maximilian-s-puglielli/6502-Computer/Images/Front#1.jpg

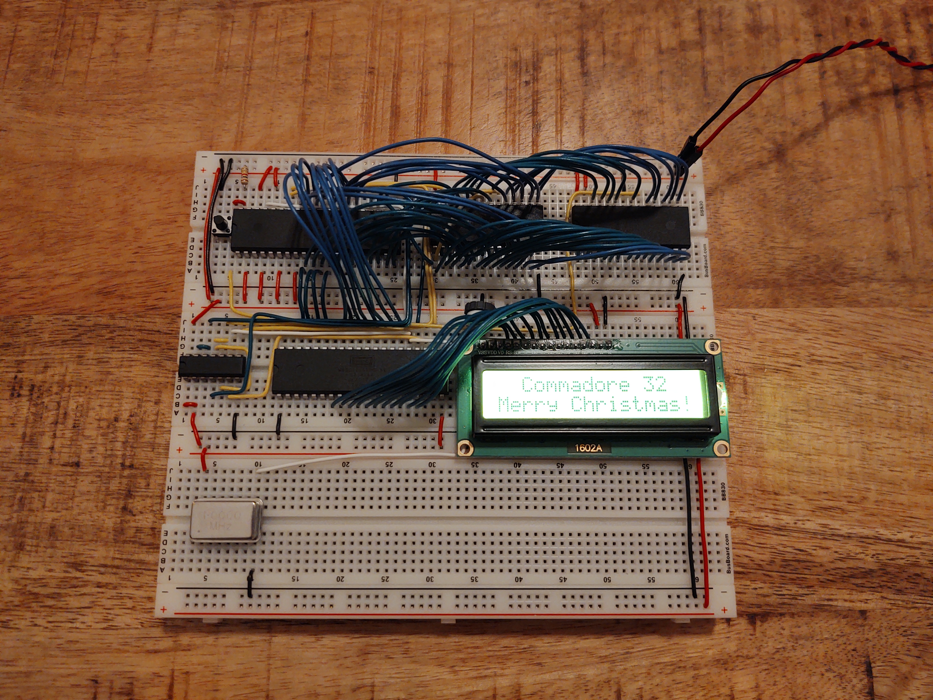
Images/Front#1.jpg
