maximilian-s-puglielli/6502-Computer/Images/FrontClose.jpg

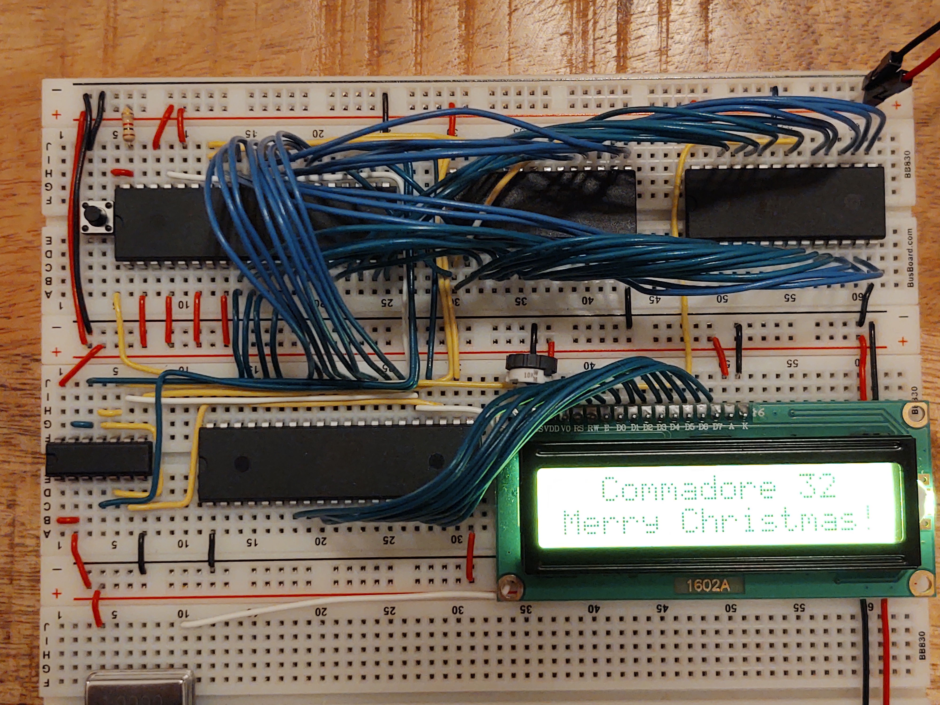
Images/FrontClose.jpg
