maximilian-s-puglielli/6502-Computer/Images/FrontLCD.jpg

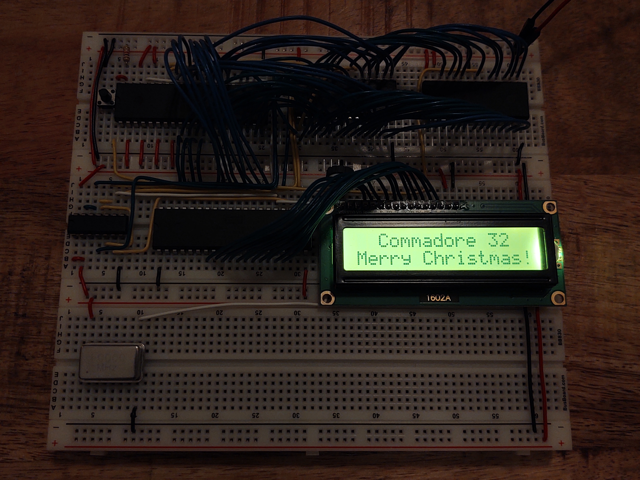
Images/FrontLCD.jpg
