maximilian-s-puglielli/6502-Computer/Images/FrontLow.jpg

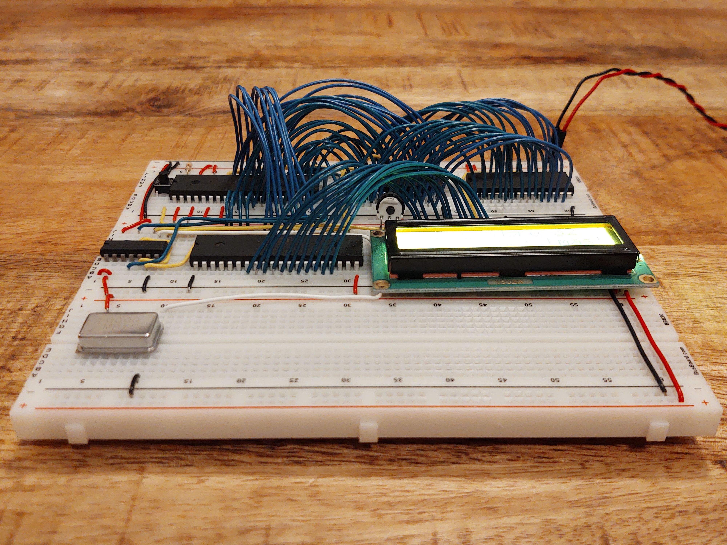
Images/FrontLow.jpg
