maximilian-s-puglielli/6502-Computer/Images/LeftSide#1.jpg

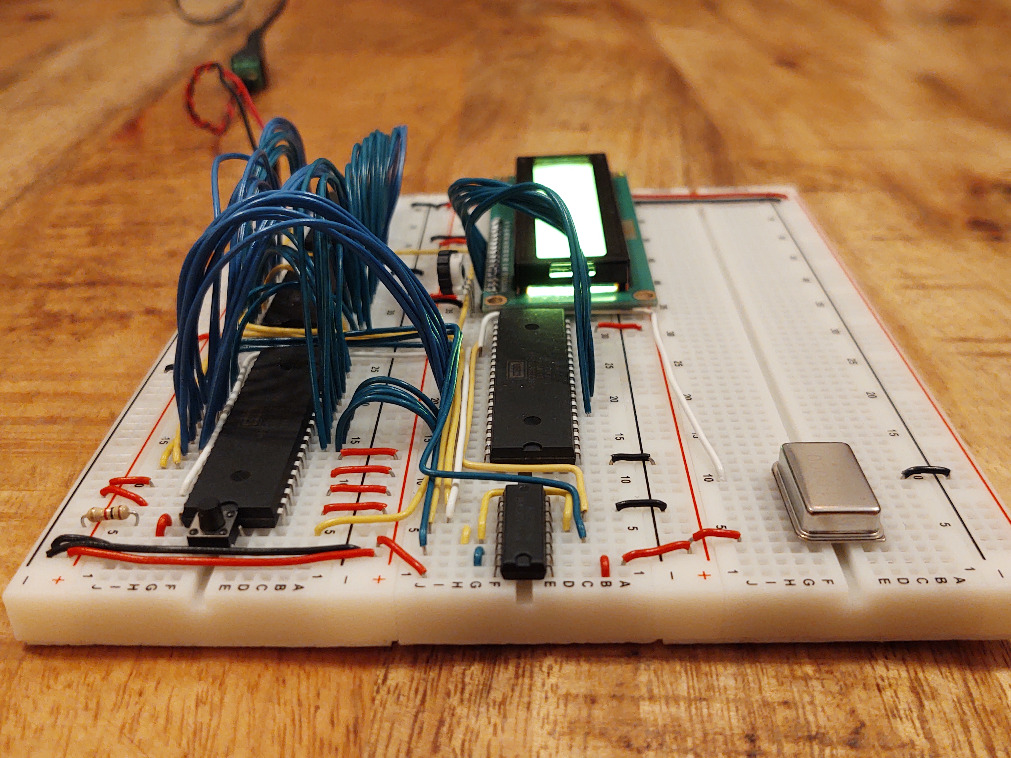
Images/LeftSide#1.jpg
