maximilian-s-puglielli/6502-Computer/Images/LeftSide#2.jpg

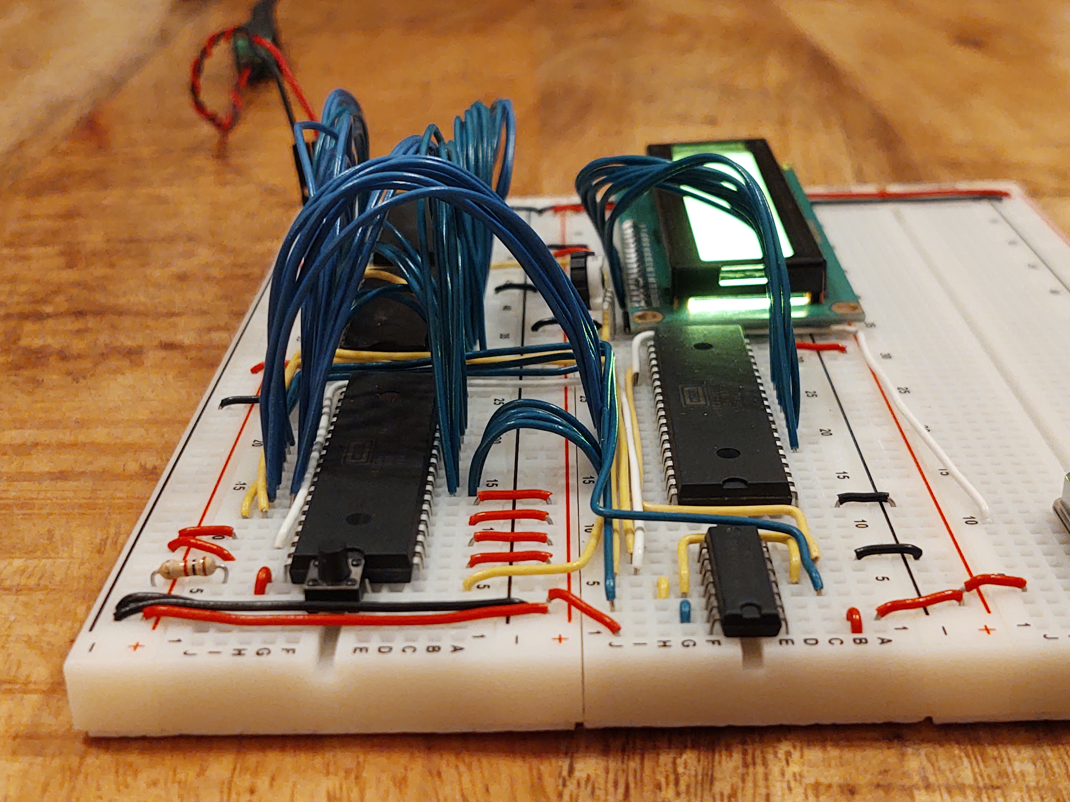
Images/LeftSide#2.jpg
