maximilian-s-puglielli/6502-Computer/Images/RightSide#1.jpg

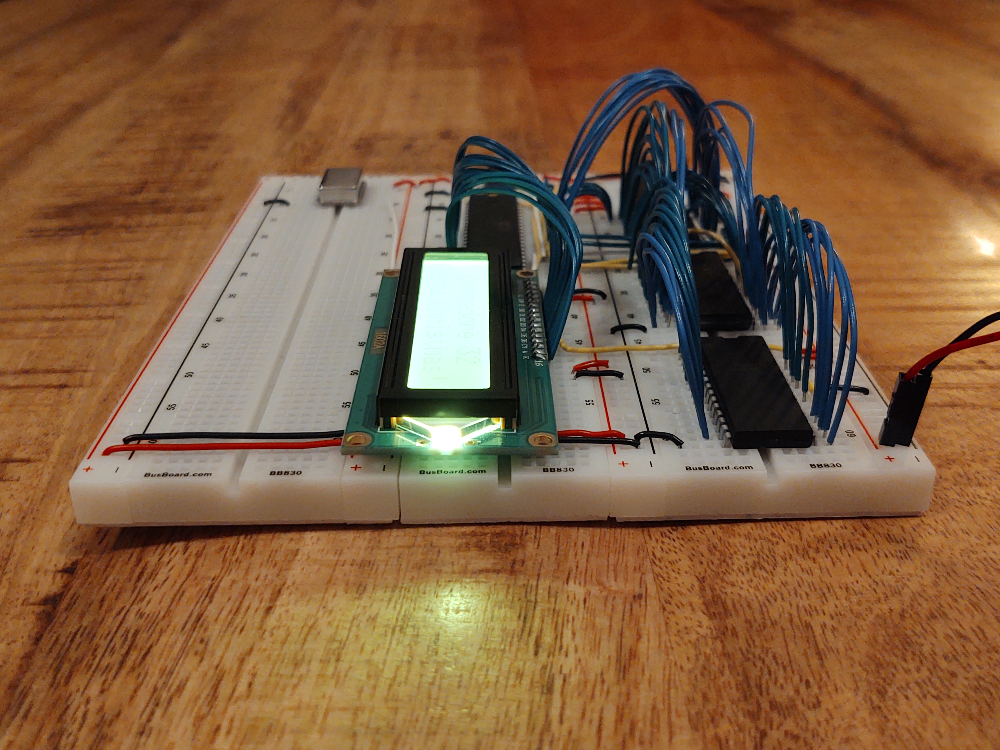
Images/RightSide#1.jpg
