maximilian-s-puglielli/6502-Computer/Images/RightSide#2.jpg

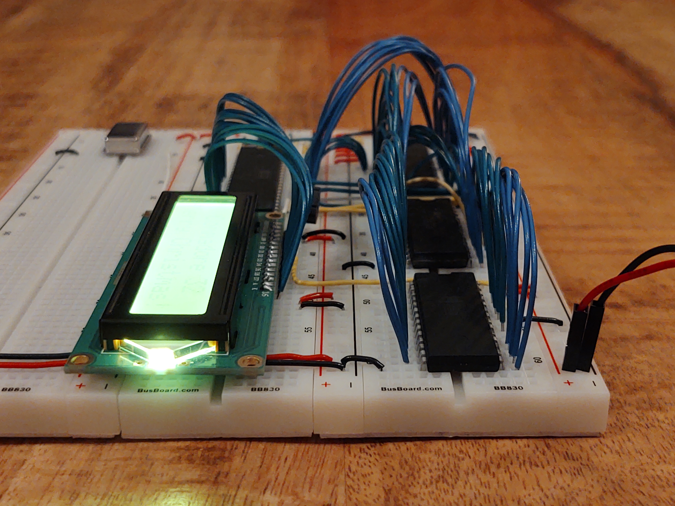
Images/RightSide#2.jpg
