maximilian-s-puglielli/6502-Computer/Images/Top.jpg

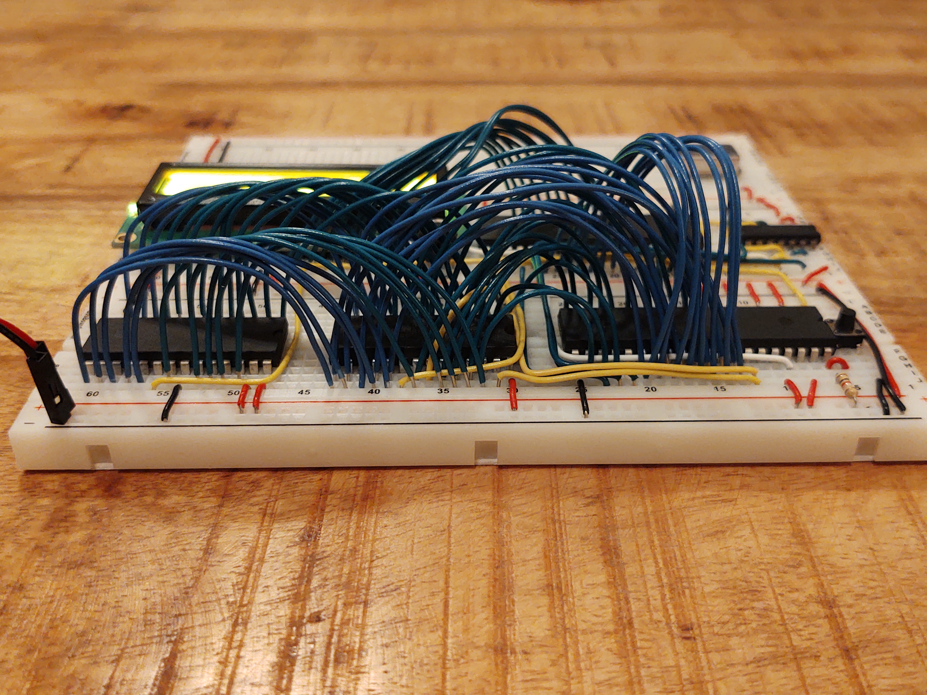
Images/Top.jpg
