maximilian-s-puglielli/6502-Computer/(commit log)

2020-12-15 Added the circuit schematic to README.md
2020-12-15 Added ArduinoPrograms
2020-12-16 Updated the arduino programs and .gitignore
2020-12-16 Moved address_reader and ardu_timer out one directory to ArduinoPrograms
2020-12-16 led loop python script made
2020-12-21 Finished up read.me, added excel tool, upd. ignor
    [wire lengths.xlsx]
2020-12-21 Renamed wire lengths.xlsx; Updated Blink.asm
    [WireLengths.xlsx, wire lengths.xlsx]
2020-12-24 Finished PrintMessage.asm; Updated Test.asm
2021-01-08 Renamed ArduinoPrograms -> Arduino, AssemblyPrograms -> Assembly, & PythonScripts -> Python
